EricDustrude/TacomaBetterHead/(list of files, drawings)

Other design files:
ExpressPCB/TacoEnhance2.pcb
