EricDustrude/TacomaBetterHead/(commit log)

2020-05-13 When gearshift is put into reverse, choose the most appropriate rear view camera automatically.
    [TacomaBetterHead.ino]
2020-05-13 Add ExpressPCB design file.
    [TacoEnhance2.pcb]
2020-05-13 Add photo of nearly completed relay shield.
2020-05-13 Update README.md
    Add picture of actual board and parts list.
